ec463/teensy-custom-audio/resources/EC464_Poster_Resources/Device_Internals/Block_Diagram_Description.txt

OverEar has three main features: dual microphone input, the processing unit, and earbud output.
This processor has been set up to perform sound segregation on the input using a low-frequency filter, amplitude minimization, and cross-correlation amplification.
