ec463/teensy-custom-audio/resources/EC464_Poster_Resources/Device_Internals/Internals_Description.txt

OverEar consists of a custom-manufactured PCB, two electret microphones, I/O electronics, a Li-Po battery, a Teensy 3.5 microcontroller, and a Teensy audio shield.
