ec463/teensy-custom-audio/resources/EC464_Poster_Resources/Device_Internals/IO_Description.txt

Volume Knob for adjusting output volume
Mute button to stop processing when user is speaking
Mini-USB charging built-in
