ec463/teensy-custom-audio/resources/EC464_Poster_Resources/Device_Internals/PCB_Schematic_Description.txt

Internal circuit diagram and PCB layout for the OverEar device.
Designed to keep the device small and portable
