ec463/teensy-custom-audio/resources/EC464_Poster_Resources/Results/Specifications.docx

Specification | Quantity
Battery Life | 28 hours
Weight | 205 grams
Range of Operation | 20° from in front of user
Size | 120 x 80 x 40 mm
Processing Delay | Negligible
Cost | < $100
