ec463/teensy-custom-audio/resources/schematic/overear_schematic.pdf

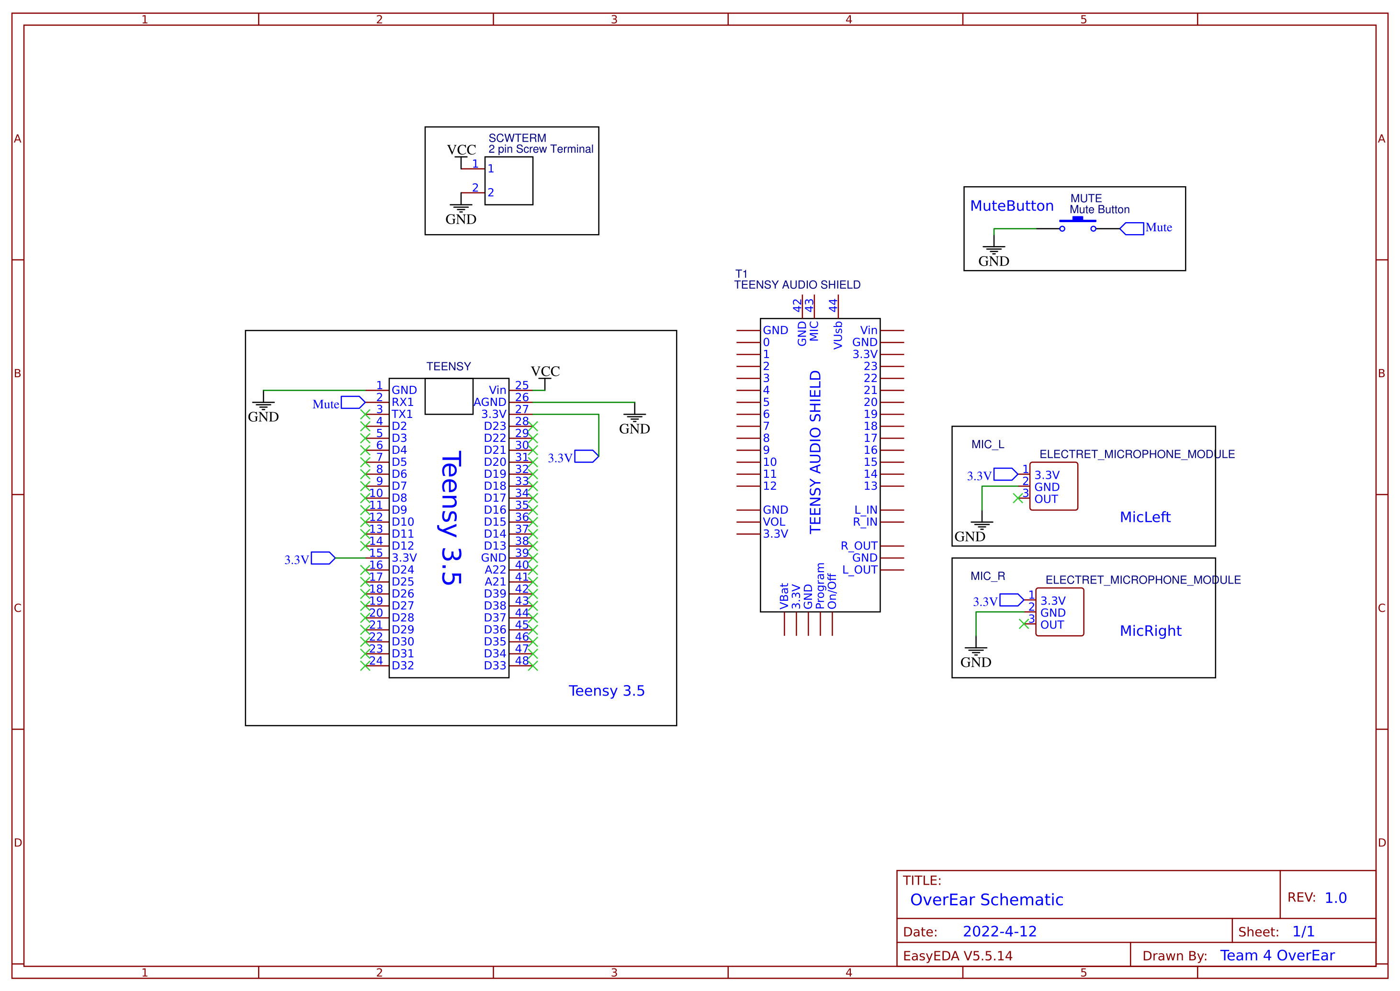
[picture p18: page 1]
