ec463/teensy-custom-audio/resources/pcb/overear_pcb.pdf

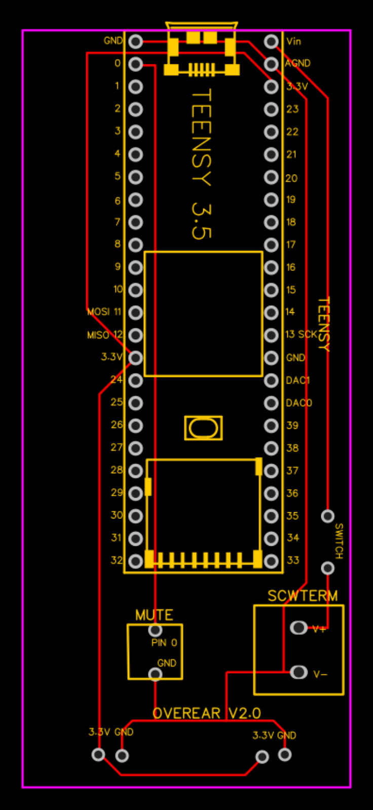
[picture p19: page 1]
