ec463/teensy-custom-audio/resources/EC464_Poster_Resources/Device_Internals/OverEar_Block_Diagram.png

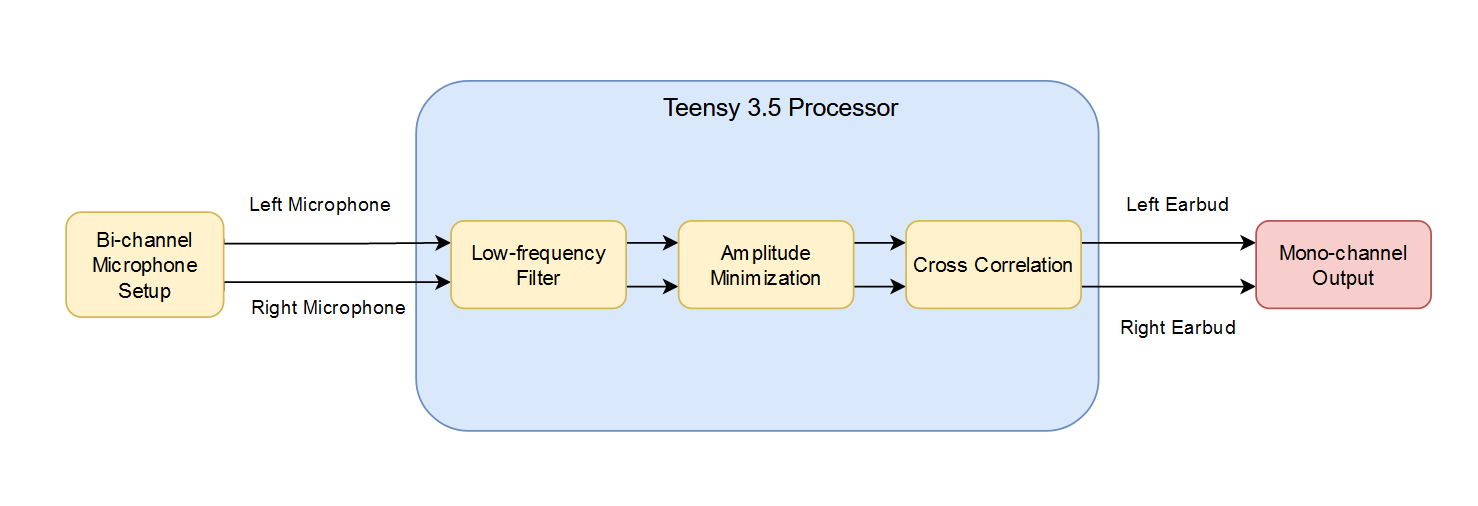
resources/EC464_Poster_Resources/Device_Internals/OverEar_Block_Diagram.png
