ec463/teensy-custom-audio/resources/hardware_figures/insidedescription.png

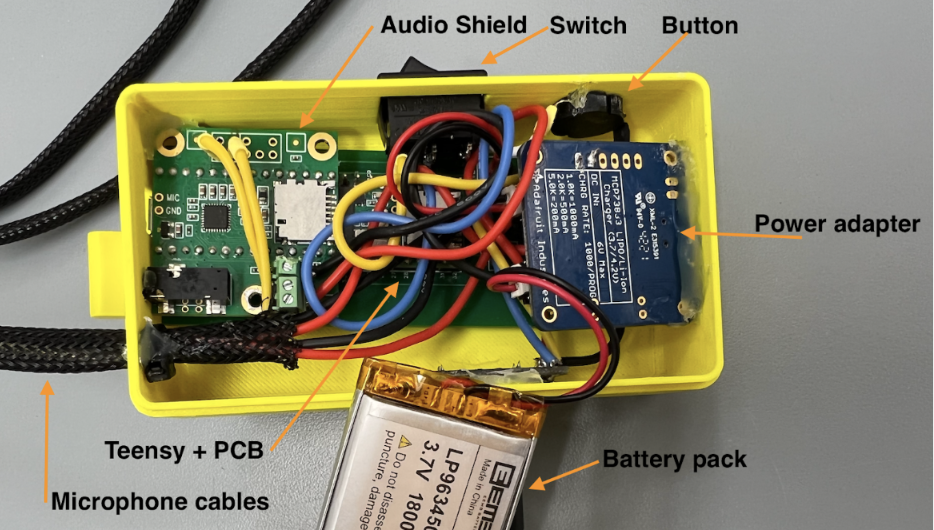
resources/hardware_figures/insidedescription.png
