ec463/teensy-custom-audio/resources/images/Figure1.JPG

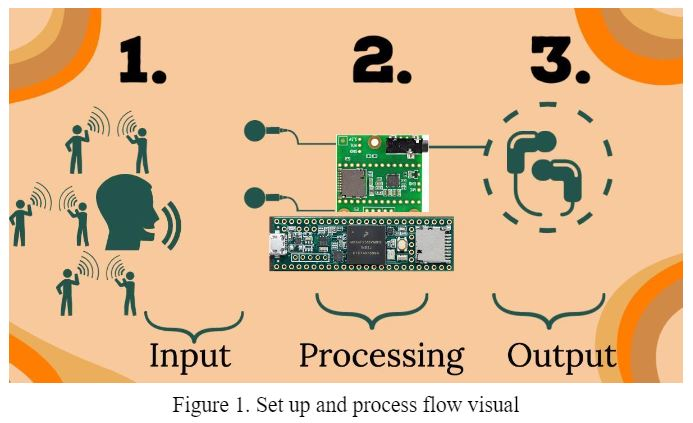
resources/images/Figure1.JPG
