ec463/teensy-custom-audio/resources/images/Figure2.JPG

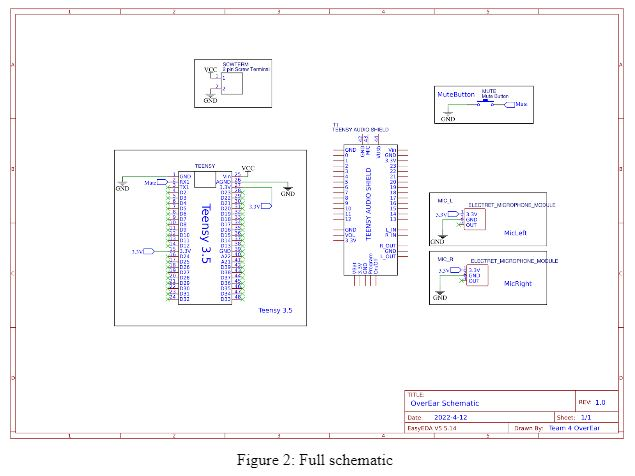
resources/images/Figure2.JPG
