ec463/teensy-custom-audio/resources/images/Figure3.JPG

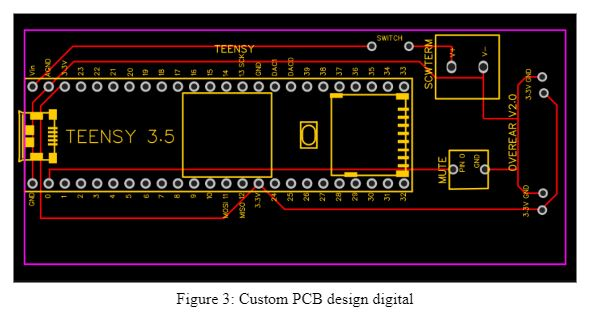
resources/images/Figure3.JPG
