ec463/teensy-custom-audio/resources/images/Figure4.JPG

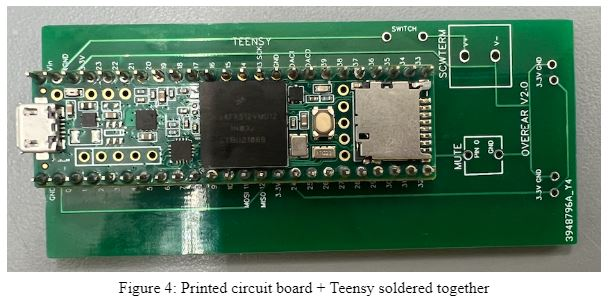
resources/images/Figure4.JPG
