ec463/teensy-custom-audio/resources/images/Figure5.JPG

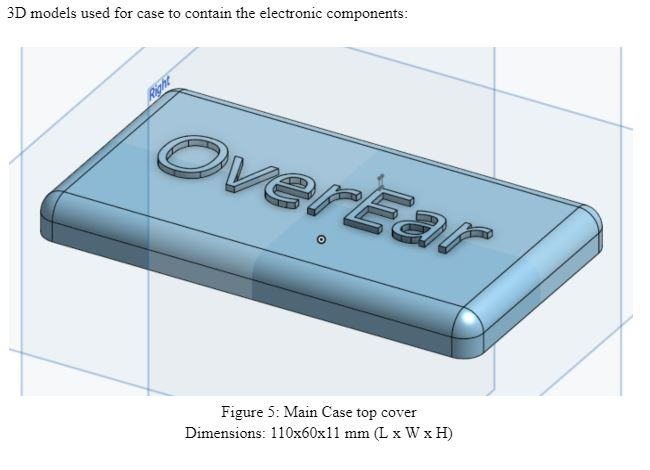
resources/images/Figure5.JPG
