ec463/teensy-custom-audio/resources/images/Figure6.JPG

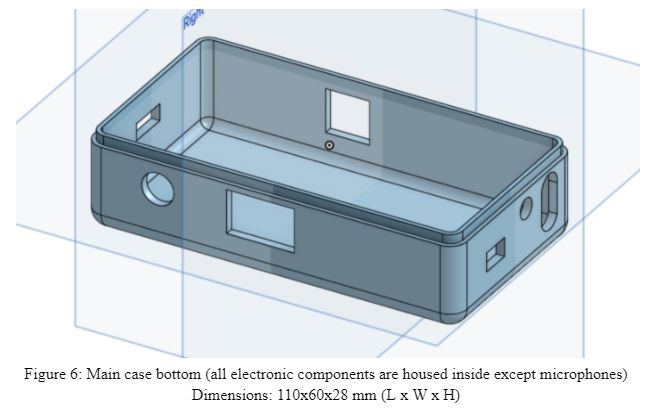
resources/images/Figure6.JPG
