ec463/teensy-custom-audio/resources/images/Figure7.JPG

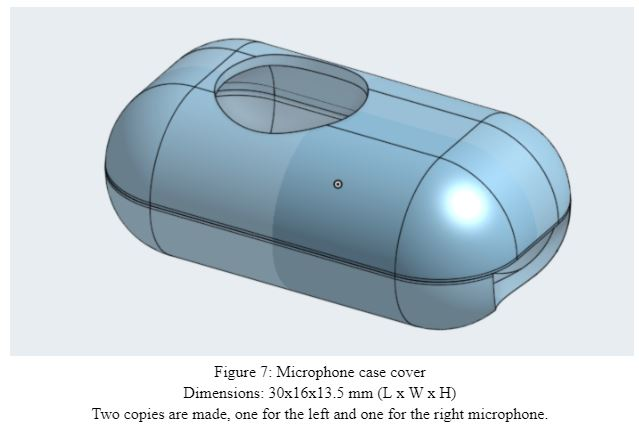
resources/images/Figure7.JPG
