ec463/teensy-custom-audio/resources/images/Figure8.JPG

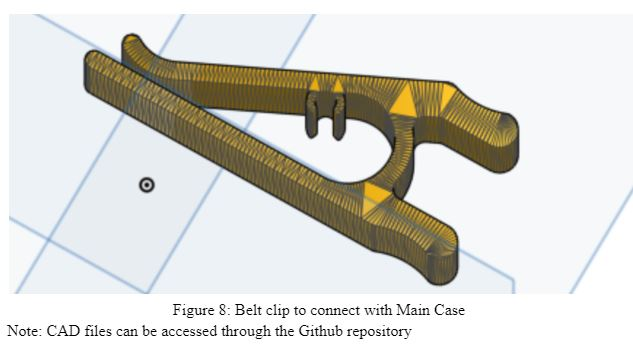
resources/images/Figure8.JPG
