ec463/teensy-custom-audio/resources/images/Figure9.JPG

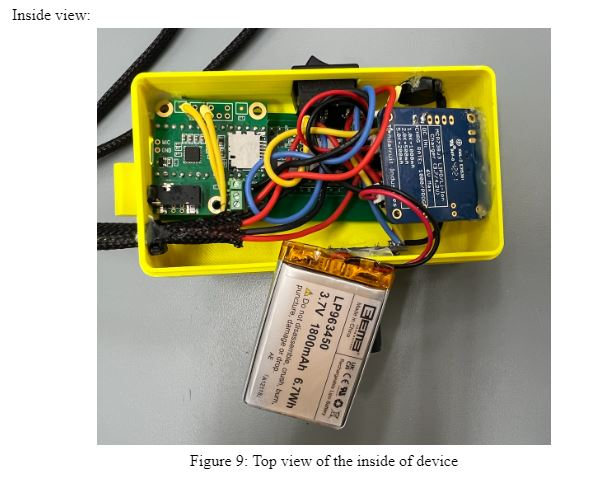
resources/images/Figure9.JPG
