ec463/teensy-custom-audio/resources/images/Figure10.JPG

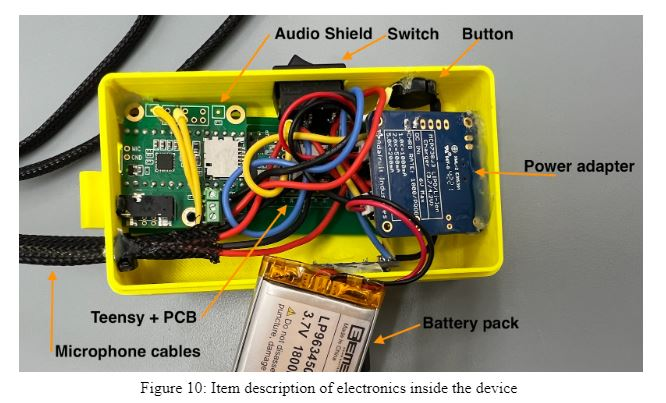
resources/images/Figure10.JPG
