ec463/teensy-custom-audio/resources/images/Figure11.JPG

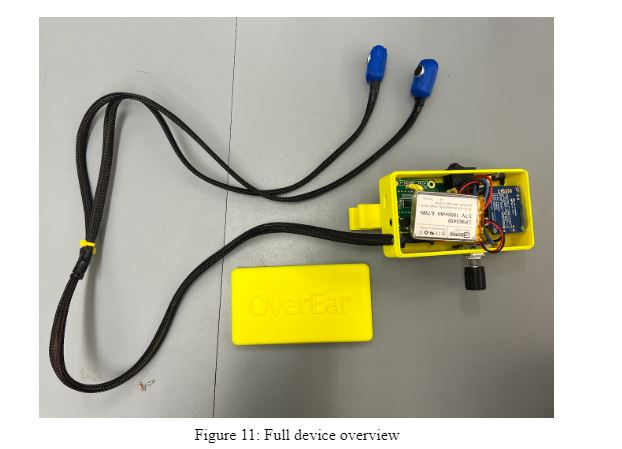
resources/images/Figure11.JPG
