ec463/teensy-custom-audio/resources/EC464_Poster_Resources/Results/Cost_Breakdown.docx

Project Costs for Production of Beta Version (Next Unit after Prototype)
Item | Quantity | Description | Unit Cost ($) | Extended Cost ($)
1 Teensy 3.5 | 1 | Development board/Microcontroller | 36.73 | 36.73
2 Teensy Audio Shield | 1 | Audio adaptor | 17.00 | 17.00
3 Microphone | 2 | MAX4466 with Adjustable Gain | 2.00 | 4.00
4 Battery | 1 | 1000 mAh, Li-Po | 8.99 | 8.99
5 3D prints | 1 | Casing for device components | 12.00 | 12.00
6 Mute Pushbutton Button | 1 | Microcenter Pushbutton Switch | 2.00 | 2.00
7 Volume Knob | 1 | Rotary Encoder | 4.00 | 4.00
8 On/Off Switch | 1 | Unbranded Switch | 2.00 | 2.00
9 PCB | 1 | Custom PCB that connects all electronics | 1.50 | 1.50
10 Misc | 1 | Wires, terminals, etc. | 1.00 | 1.00
Beta Version-Total Cost | | | | 89.25
