ec463/teensy-custom-audio/resources/images/BOM.JPG

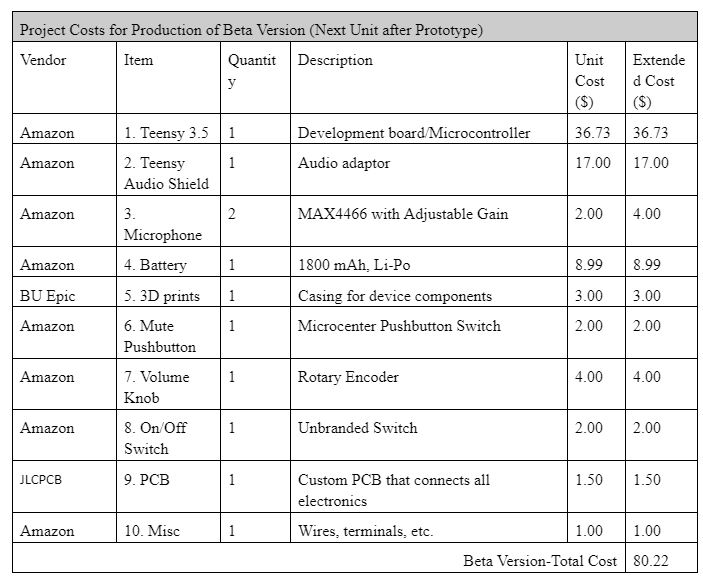
resources/images/BOM.JPG
