ec463/teensy-custom-audio/resources/EC464_Poster_Resources/Results/Tone/OverEar_Tone_0_degrees.png

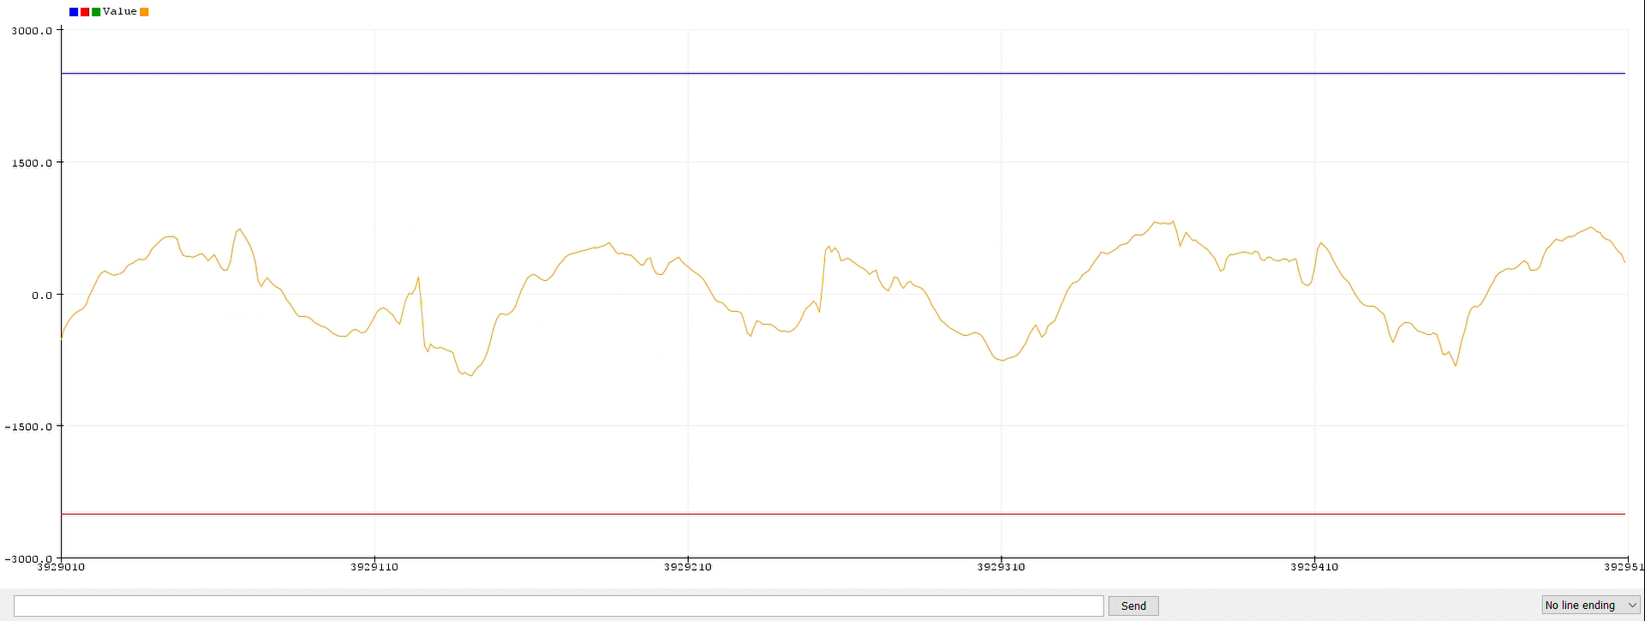
resources/EC464_Poster_Resources/Results/Tone/OverEar_Tone_0_degrees.png
