ec463/teensy-custom-audio/resources/EC464_Poster_Resources/Results/Tone/OverEar_Tone_-90_degrees.png

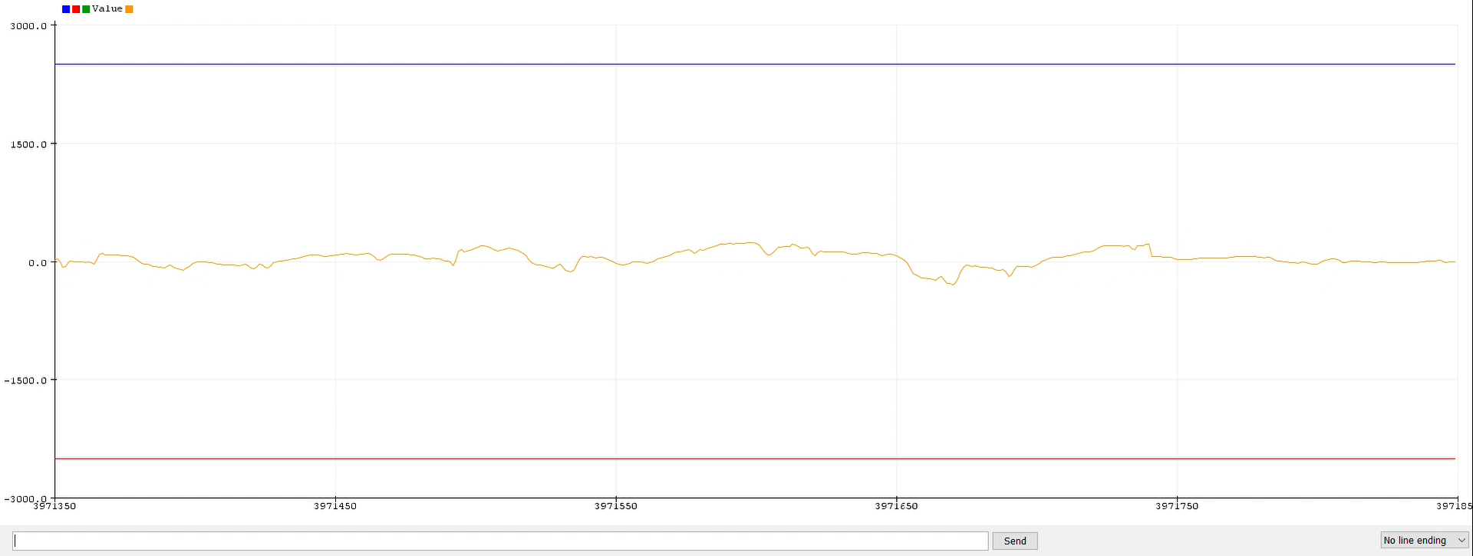
resources/EC464_Poster_Resources/Results/Tone/OverEar_Tone_-90_degrees.png
