ec463/teensy-custom-audio/(commit log)

2022-02-01 Initial push, no code changes from teensy library
2022-02-08 push button
2022-02-08 push button working
2022-02-25 Added low-frequency filter -> xcorr -> isolate min algorithm (#1)
2022-02-27 Added circuit and pcb diagrams
2022-04-26 Volume Knob and Mute Button Working (#2)
    * Cleaned up volume knob code, added mute switch functionality
